JonatanMP/Jonatan_Matos_Electiva_2025_C2/Garabato I investigacion/garabato.jpg

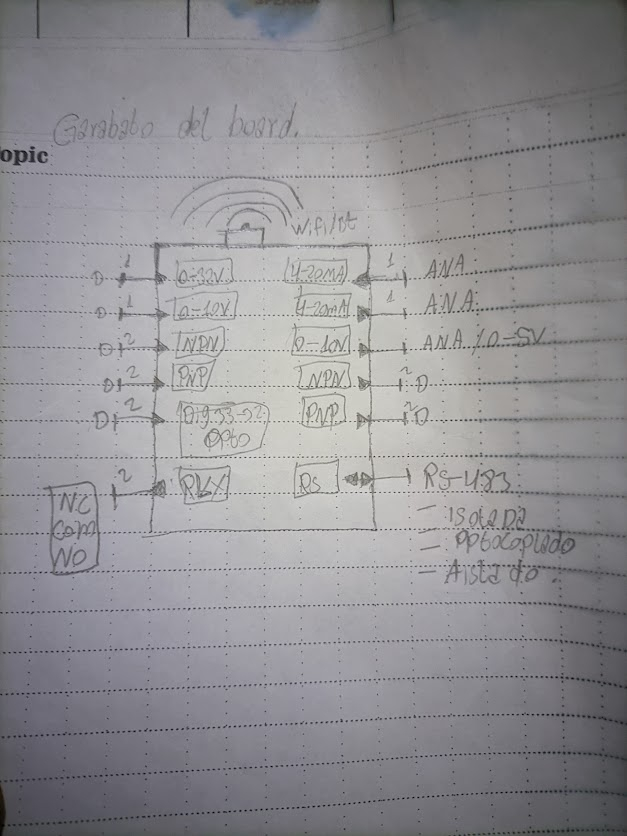
Garabato I investigacion/garabato.jpg
