JonatanMP/Jonatan_Matos_Electiva_2025_C2/README.md

# Jonatan_Matos_Electiva_2025_C2
HOLA PCB

_________________________________
