JonatanMP/Jonatan_Matos_Electiva_2025_C2/Garabato I investigacion/shematics guias/DIAGRAM.pdf

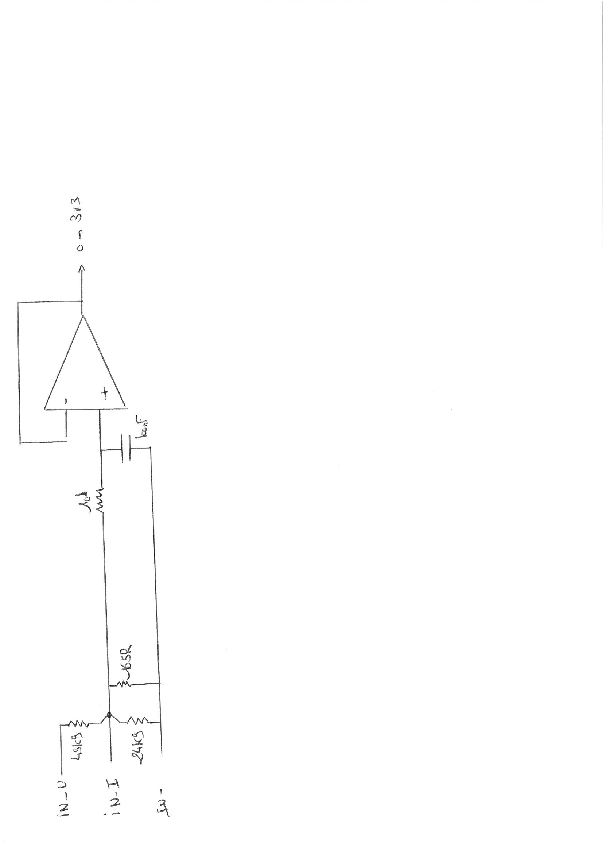
[picture p3: page 1]
