JonatanMP/Jonatan_Matos_Electiva_2025_C2/Garabato I investigacion/shematics guias/8877.Schematic_4_20mA_0_10V.png-1230x0.png

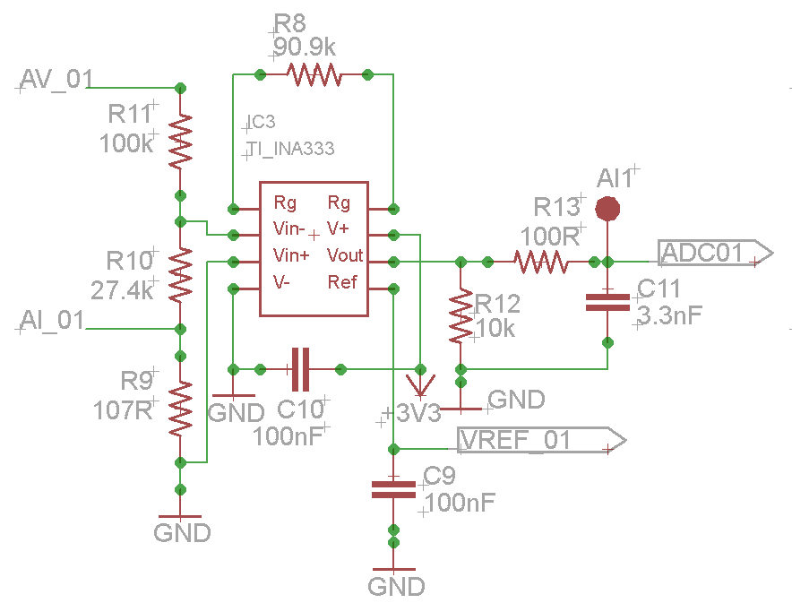
Garabato I investigacion/shematics guias/8877.Schematic_4_20mA_0_10V.png-1230x0.png
