JonatanMP/Jonatan_Matos_Electiva_2025_C2/Garabato I investigacion/shematics guias/Altium.PNG

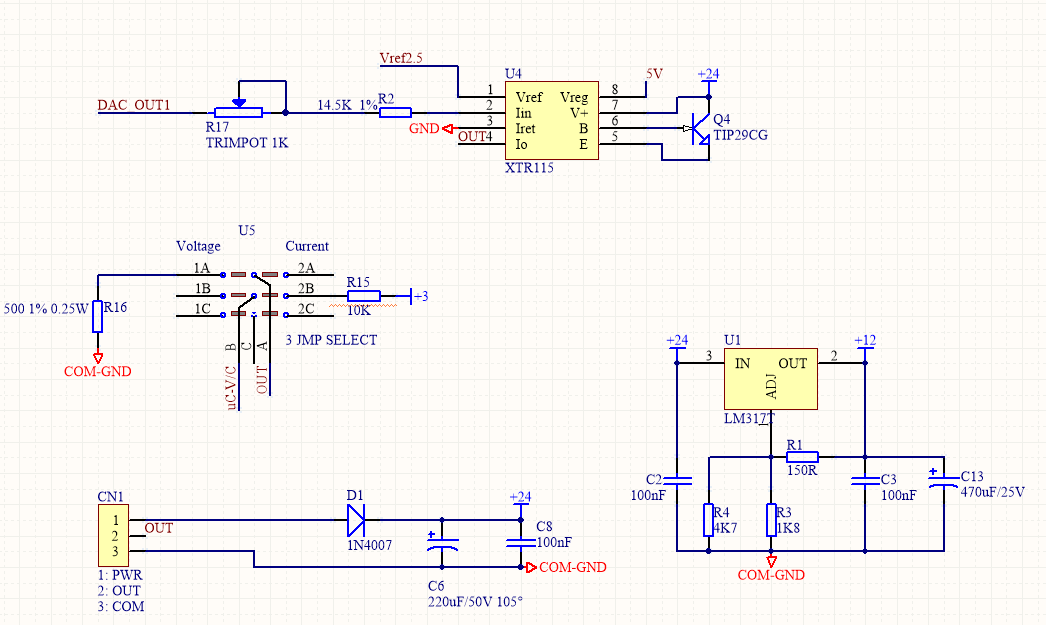
Garabato I investigacion/shematics guias/Altium.PNG
