JonatanMP/Jonatan_Matos_Electiva_2025_C2/Garabato I investigacion/shematics guias/Current_Limit_Fig37.JPG-1230x0.jpg

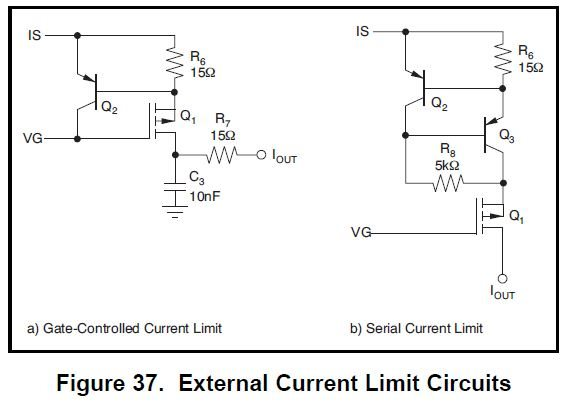
Garabato I investigacion/shematics guias/Current_Limit_Fig37.JPG-1230x0.jpg
