JonatanMP/Jonatan_Matos_Electiva_2025_C2/Garabato I investigacion/shematics guias/NPN I PNP.png

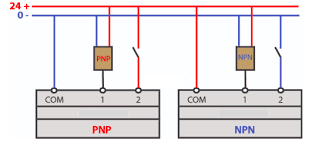
Garabato I investigacion/shematics guias/NPN I PNP.png
