JonatanMP/Jonatan_Matos_Electiva_2025_C2/CAD/3D/FreeCad/Case PLC.FCStd

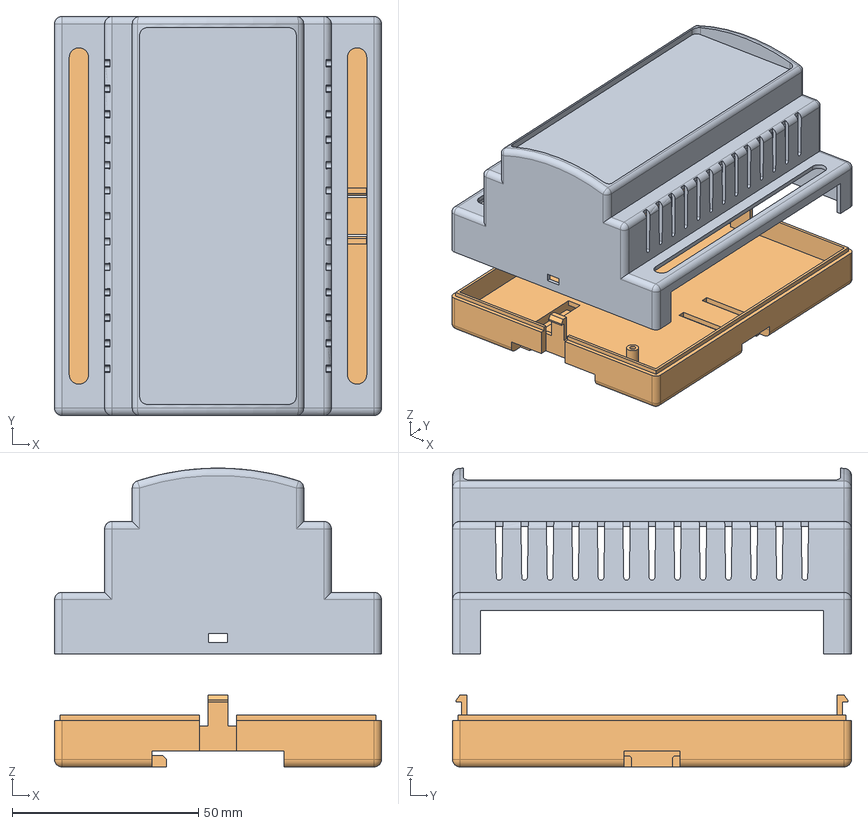
[picture p9: CAD file, 2025-06-11]
CAD/3D/FreeCad/Case PLC.FCStd
87.7 x 107.0 x 80.1 mm
Case
Base
