JonatanMP/Jonatan_Matos_Electiva_2025_C2/CAD/2D/FreeCad/TOP_VIEW_Base.dxf

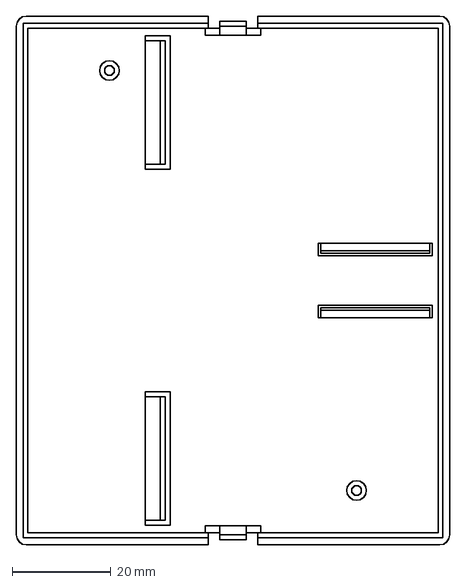
[picture p10: CAD file, 2025-06-11]
CAD/2D/FreeCad/TOP_VIEW_Base.dxf
87.7 x 107.0 mm
