JonatanMP/Jonatan_Matos_Electiva_2025_C2/NIVARA_PCB/NIVARA/NIVARA.kicad_pcb

## KiCad design NIVARA_PCB/NIVARA/NIVARA.kicad_pcb (2025-08-22)

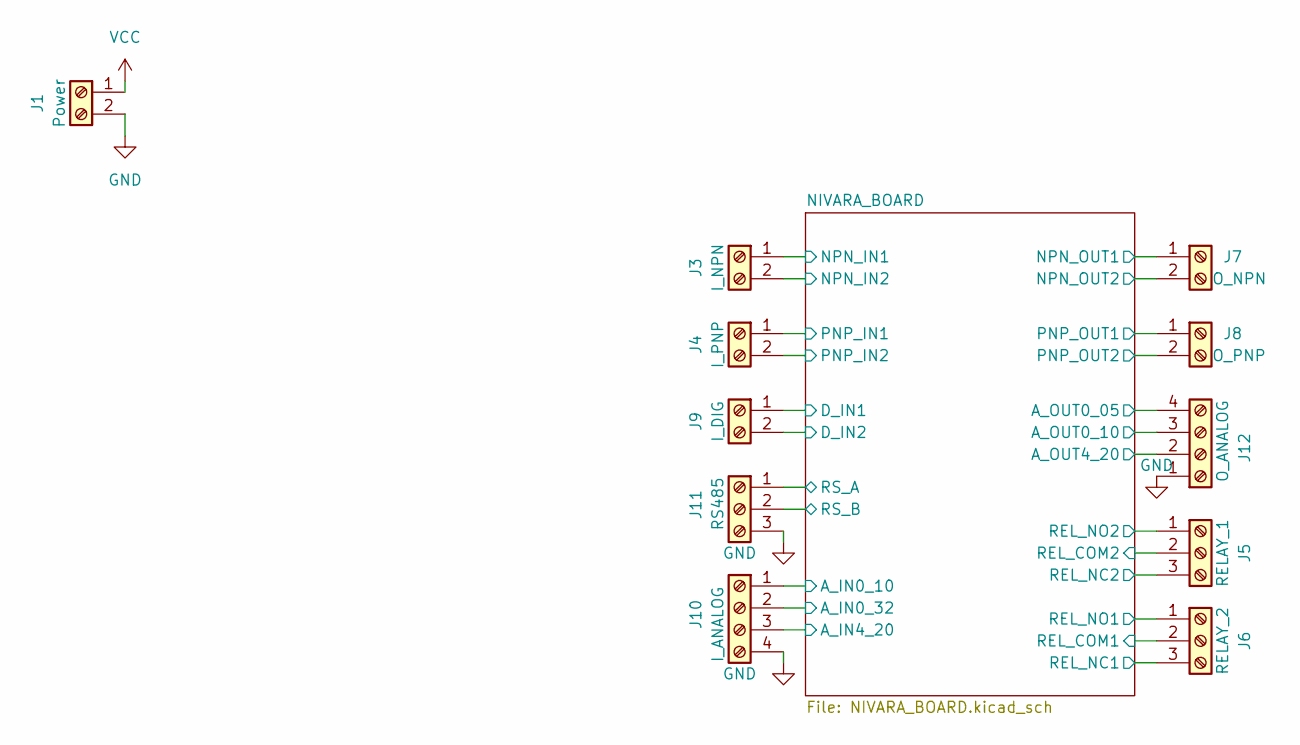
[picture p11: schematic NIVARA.kicad_sch]

Parts:
J1: Power; TerminalBlock_bornier-2_P5.08mm; PART NUMBERT DB128L-5.08-2P-OG-S
J3: I_NPN; TerminalBlock_bornier-2_P5.08mm; PART NUMBERT WJ500V-5.08-2P
J4: I_PNP; TerminalBlock_bornier-2_P5.08mm; PART NUMBERT WJ500V-5.08-2P
J5: RELAY_1; TerminalBlock_bornier-3_P5.08mm; PART NUMBERT WJ500V-5.08-3P
J6: RELAY_2; TerminalBlock_bornier-3_P5.08mm; PART NUMBERT WJ500V-5.08-3P
J7: O_NPN; TerminalBlock_bornier-2_P5.08mm; PART NUMBERT WJ500V-5.08-2P
J8: O_PNP; TerminalBlock_bornier-2_P5.08mm; PART NUMBERT WJ500V-5.08-2P
J9: I_DIG; TerminalBlock_bornier-2_P5.08mm; PART NUMBERT WJ500V-5.08-2P
J10: I_ANALOG; TerminalBlock_bornier-4_P5.08mm; PART NUMBERT WJ500V-5.08-4P
J11: RS485; TerminalBlock_bornier-3_P5.08mm; PART NUMBERT WJ500V-5.08-3P
J12: O_ANALOG; TerminalBlock_bornier-4_P5.08mm; PART NUMBERT WJ500V-5.08-4P

Connections:
/NIVARA_BOARD/A_IN0_10: J10.1; also elsewhere on the board
/NIVARA_BOARD/A_IN0_32: J10.2; also elsewhere on the board
/NIVARA_BOARD/A_IN4_20: J10.3; also elsewhere on the board
/NIVARA_BOARD/A_OUT0_05: J12.4; also elsewhere on the board
/NIVARA_BOARD/A_OUT0_10: J12.3; also elsewhere on the board
/NIVARA_BOARD/A_OUT4_20: J12.2; also elsewhere on the board
/NIVARA_BOARD/D_IN1: J9.1; also elsewhere on the board
/NIVARA_BOARD/D_IN2: J9.2; also elsewhere on the board
/NIVARA_BOARD/NPN_IN1: J3.1; also elsewhere on the board
/NIVARA_BOARD/NPN_IN2: J3.2; also elsewhere on the board
/NIVARA_BOARD/NPN_OUT1: J7.1; also elsewhere on the board
/NIVARA_BOARD/NPN_OUT2: J7.2; also elsewhere on the board
/NIVARA_BOARD/PNP_IN1: J4.1; also elsewhere on the board
/NIVARA_BOARD/PNP_IN2: J4.2; also elsewhere on the board
/NIVARA_BOARD/PNP_OUT1: J8.1; also elsewhere on the board
/NIVARA_BOARD/PNP_OUT2: J8.2; also elsewhere on the board
/NIVARA_BOARD/REL_COM1: J6.2; also elsewhere on the board
/NIVARA_BOARD/REL_COM2: J5.2; also elsewhere on the board
/NIVARA_BOARD/REL_NC1: J6.3; also elsewhere on the board
/NIVARA_BOARD/REL_NC2: J5.3; also elsewhere on the board
/NIVARA_BOARD/REL_NO1: J6.1; also elsewhere on the board
/NIVARA_BOARD/REL_NO2: J5.1; also elsewhere on the board
/NIVARA_BOARD/RS_A: J11.1; also elsewhere on the board
/NIVARA_BOARD/RS_B: J11.2; also elsewhere on the board
GND: J1.2, J10.4, J11.3, J12.1; also elsewhere on the board
VCC: J1.1; also elsewhere on the board

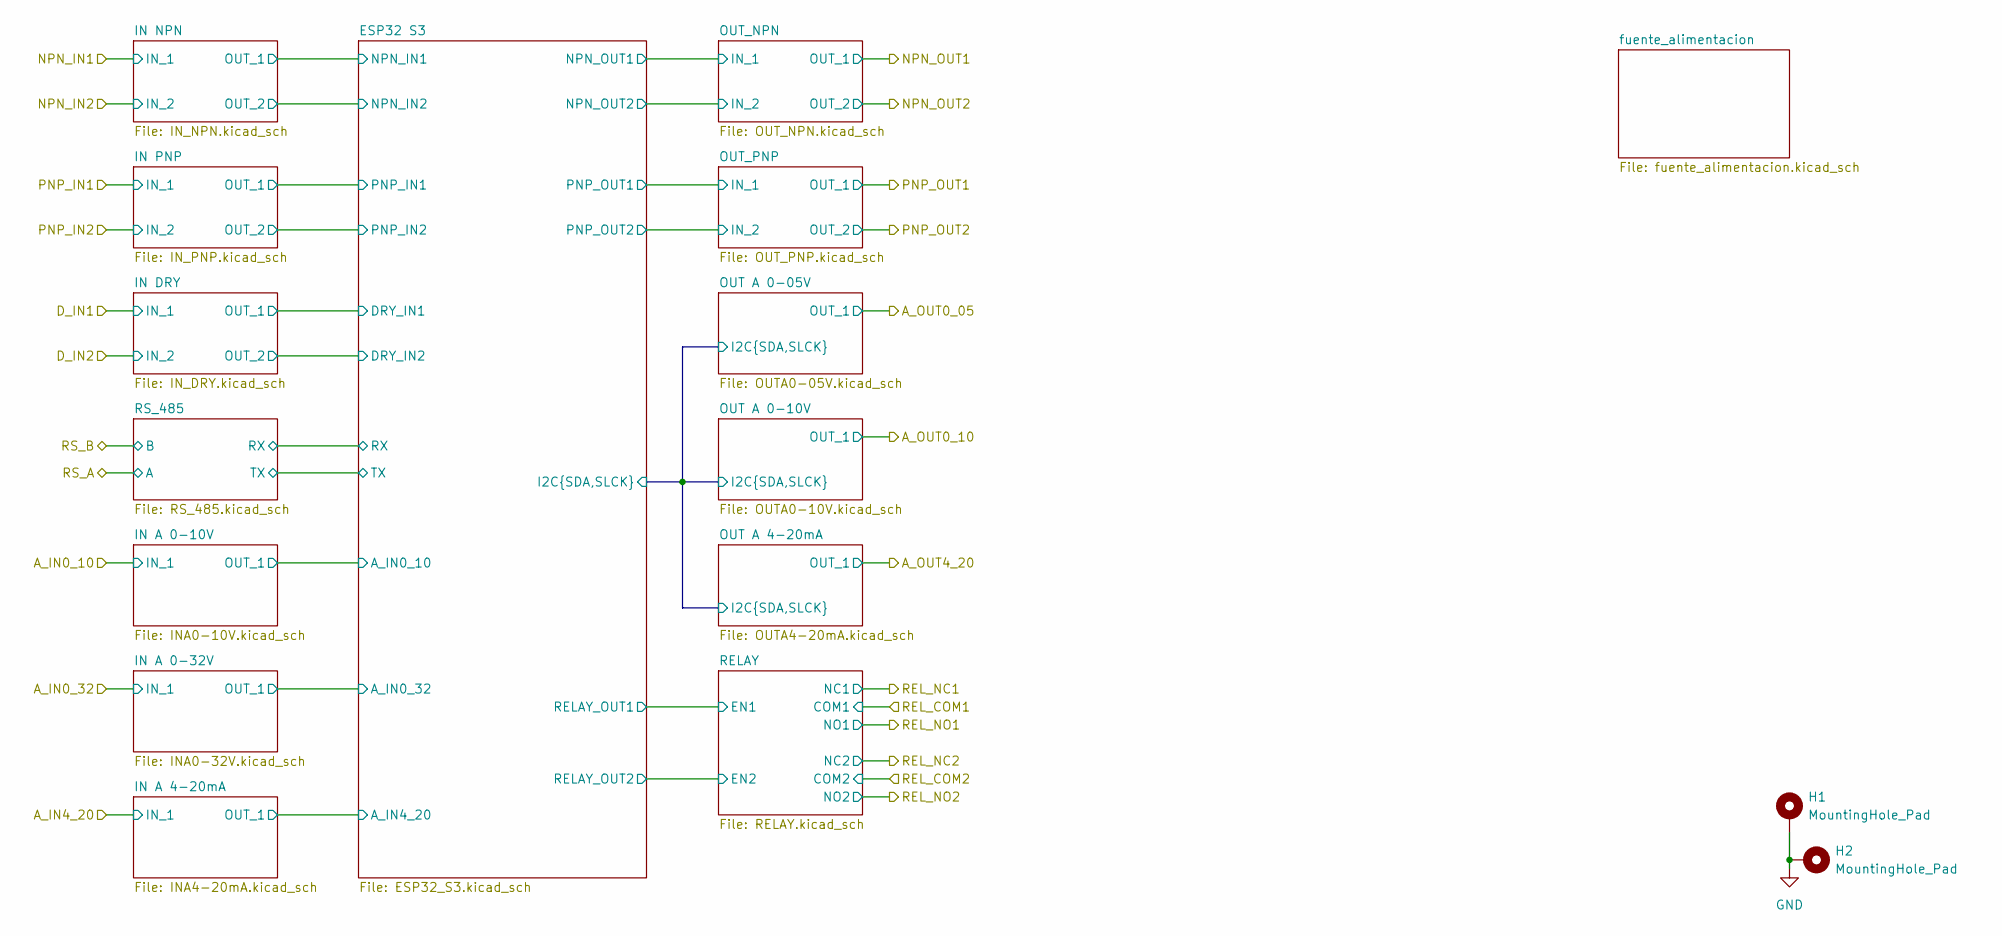
[picture p12: schematic NIVARA_BOARD.kicad_sch]

Parts:
H1, H2: MountingHole_Pad; MountingHole_2.2mm_M2_Pad_Via

Connections:
GND: H1.1, H2.1; also elsewhere on the board

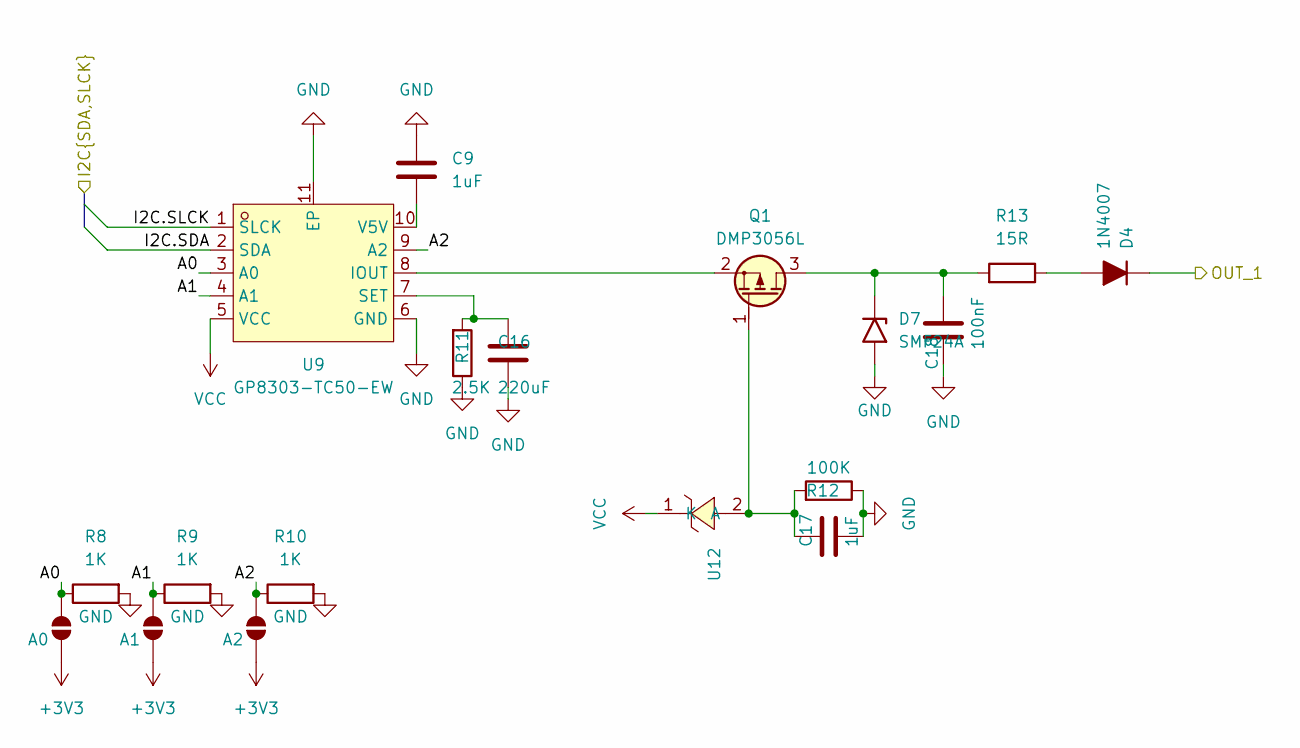
[picture p13: schematic OUTA4-20mA.kicad_sch]

Parts:
C9, C17: 1uF; C_0603_1608Metric; PART NUMBERT CL10A105KB8NNNC
C16: 220uF; C_0603_1608Metric; PART NUMBERT CC0603KRX7R9BB221
C18: 100nF; C_0603_1608Metric; PART NUMBERT CC0603KRX7R9BB104
D4: 1N4007; D_SOD-123F; PART NUMBERT 1N4007W 46MIL
D7: SMF24A; D_SMF
JP2: A0; SolderJumper-2_P1.3mm_Open_RoundedPad1.0x1.5mm
JP3: A1; SolderJumper-2_P1.3mm_Open_RoundedPad1.0x1.5mm
JP4: A2; SolderJumper-2_P1.3mm_Open_RoundedPad1.0x1.5mm
Q1: DMP3056L; SOT-23
R8, R9, R10: 1K; R_0603_1608Metric; PART NUMBERT RC0603FR-071KL
R11: 2.5K; R_0603_1608Metric; PART NUMBERT FRQ0805F2501TS
R12: 100K; R_0603_1608Metric; PART NUMBERT RC0603FR-07100KL
R13: 15R; R_1206_3216Metric; PART NUMBERT RC1206FR-0715RL
U9: GP8303-TC50-EW; ESOP-10_L4.9-W3.9-P1.00-LS6.1-BL-EP; LCSC Part C3445809
U12: ZMM12V_C5345999; LL-34_L3.5-W1.5-RD-2; LCSC Part C5345999

Connections:
+3V3: JP2.1 (A), JP3.1 (A), JP4.1 (A); also elsewhere on the board
/NIVARA_BOARD/A_OUT4_20: D4.1 (K); also elsewhere on the board
/NIVARA_BOARD/ESP32 S3/I2C.SDA: U9.2 (SDA); also elsewhere on the board
/NIVARA_BOARD/ESP32 S3/I2C.SLCK: U9.1 (SLCK); also elsewhere on the board
/NIVARA_BOARD/OUT A 4-20mA/A0: JP2.2 (B), R8.2, U9.3 (A0)
/NIVARA_BOARD/OUT A 4-20mA/A1: JP3.2 (B), R9.2, U9.4 (A1)
/NIVARA_BOARD/OUT A 4-20mA/A2: JP4.2 (B), R10.2, U9.9 (A2)
GND: C9.1, C16.2, C17.2, C18.1, D7.2 (A2), R8.1, R9.1, R10.1, R11.2, R12.2, U9.6 (GND), U9.11 (EP); also elsewhere on the board
unnamed: D4.2 (A), R13.2
unnamed: C18.2, D7.1 (A1), Q1.3 (D), R13.1
unnamed: C17.1, Q1.1 (G), R12.1, U12.2 (A)
unnamed: Q1.2 (S), U9.8 (IOUT)
unnamed: C16.1, R11.1, U9.7 (SET)
unnamed: C9.2, U9.10 (V5V)
VCC: U9.5 (VCC), U12.1 (K); also elsewhere on the board

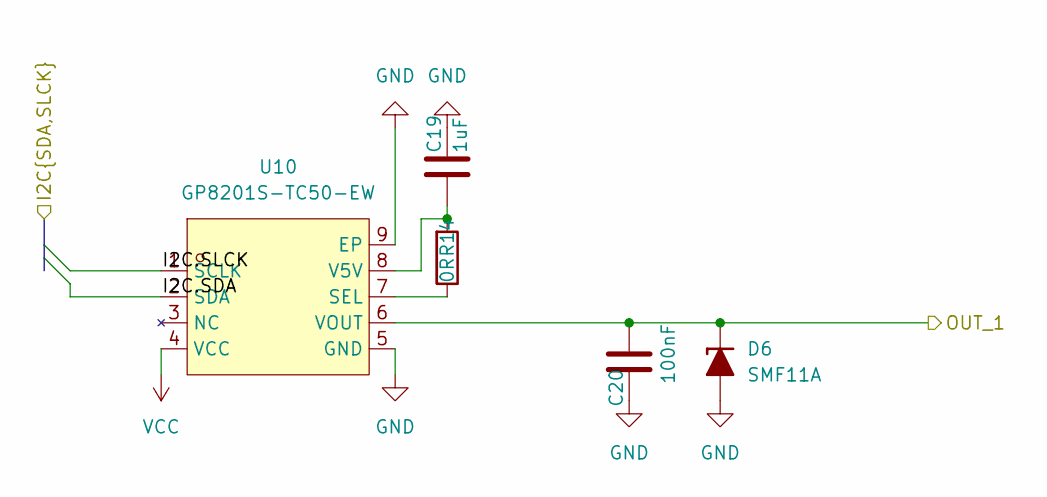
[picture p14: schematic OUTA0-10V.kicad_sch]

Parts:
C19: 1uF; C_0603_1608Metric; PART NUMBERT CL10A105KB8NNNC
C20: 100nF; C_0603_1608Metric; PART NUMBERT CC0603KRX7R9BB104
D6: SMF11A; D_SOD-123F
R14: 0R; R_0603_1608Metric; PART NUMBERT RC0603FR-070RL
U10: GP8201S-TC50-EW; ESOP-8_L4.9-W3.9-P1.27-LS6.0-BL-EP; LCSC Part C5240058

Connections:
/NIVARA_BOARD/A_OUT0_10: C20.2, D6.1 (K), U10.6 (VOUT); also elsewhere on the board
/NIVARA_BOARD/ESP32 S3/I2C.SDA: U10.2 (SDA); also elsewhere on the board
/NIVARA_BOARD/ESP32 S3/I2C.SLCK: U10.1 (SCLK); also elsewhere on the board
GND: C19.1, C20.1, D6.2 (A), U10.5 (GND), U10.9 (EP); also elsewhere on the board
unnamed: R14.2, U10.7 (SEL)
unnamed: C19.2, R14.1, U10.8 (V5V)
VCC: U10.4 (VCC); also elsewhere on the board

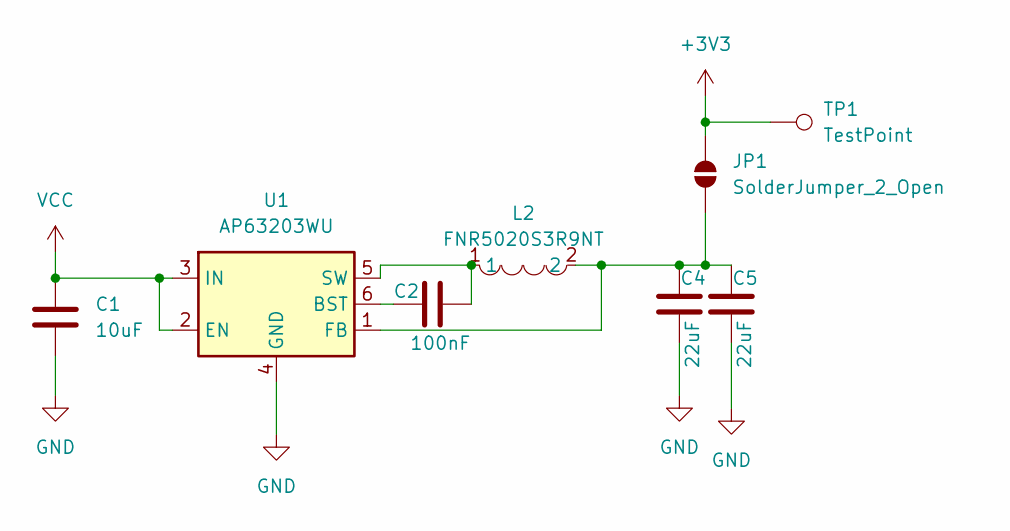
[picture p15: schematic fuente_alimentacion.kicad_sch]

Parts:
C1: 10uF; C_1206_3216Metric; PART NUMBERT CL31A106KBHNNNE
C2: 100nF; C_0603_1608Metric; PART NUMBERT CC0603KRX7R9BB104
C4, C5: 22uF; C_0603_1608Metric; PART NUMBERT CL10A226MP8NUNE
JP1: SolderJumper_2_Open; SolderJumper-2_P1.3mm_Open_RoundedPad1.0x1.5mm
L2: FNR5020S3R9NT; IND-SMD_L5.0-W5.0_FNR50XXS; LCSC Part C167928
TP1: TestPoint; TestPoint_THTPad_D1.0mm_Drill0.5mm
U1: AP63203WU; TSOT-23-6; PART NUMBERT AP63203WU-7

Connections:
+3V3: JP1.2 (B), TP1.1; also elsewhere on the board
GND: C1.2, C4.2, C5.2, U1.4 (GND); also elsewhere on the board
unnamed: C4.1, C5.1, JP1.1 (A), L2.2, U1.1 (FB)
unnamed: C2.1, U1.6 (BST)
unnamed: C2.2, L2.1, U1.5 (SW)
VCC: C1.1, U1.2 (EN), U1.3 (IN); also elsewhere on the board

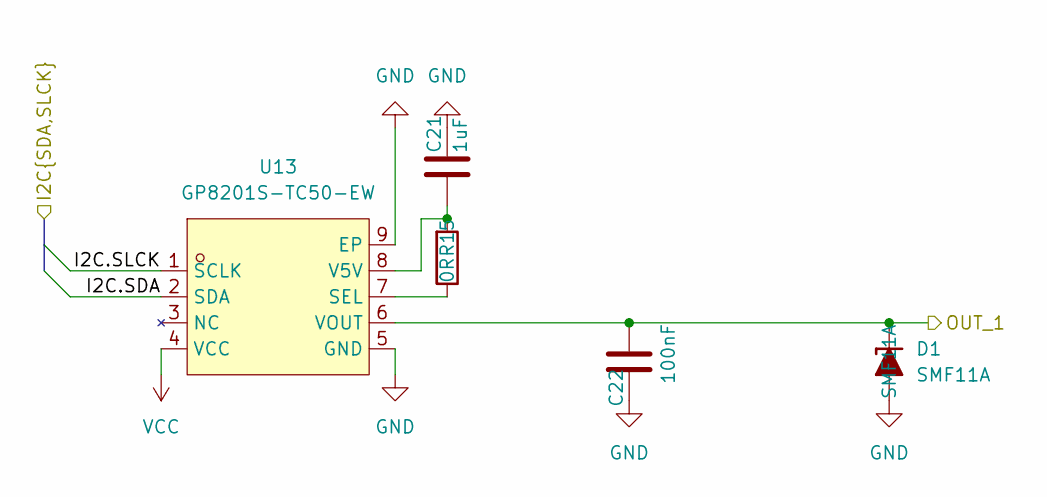
[picture p16: schematic OUTA0-05V.kicad_sch]

Parts:
C21: 1uF; C_0603_1608Metric; PART NUMBERT CL10A105KB8NNNC
C22: 100nF; C_0603_1608Metric; PART NUMBERT CC0603KRX7R9BB104
D1: SMF11A; D_SOD-123F; PART NUMBERT SMF11A
R15: 0R; R_0603_1608Metric; PART NUMBERT RC0603FR-070RL
U13: GP8201S-TC50-EW; ESOP-8_L4.9-W3.9-P1.27-LS6.0-BL-EP; LCSC Part C5240058

Connections:
/NIVARA_BOARD/A_OUT0_05: C22.2, D1.1 (K), U13.6 (VOUT); also elsewhere on the board
/NIVARA_BOARD/ESP32 S3/I2C.SDA: U13.2 (SDA); also elsewhere on the board
/NIVARA_BOARD/ESP32 S3/I2C.SLCK: U13.1 (SCLK); also elsewhere on the board
GND: C21.1, C22.1, D1.2 (A), U13.5 (GND), U13.9 (EP); also elsewhere on the board
unnamed: R15.2, U13.7 (SEL)
unnamed: C21.2, R15.1, U13.8 (V5V)
VCC: U13.4 (VCC); also elsewhere on the board

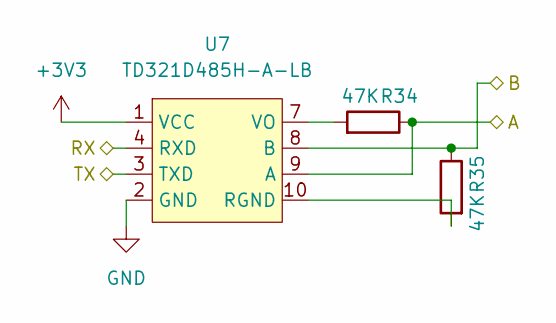
[picture p17: schematic RS_485.kicad_sch]

Parts:
R34, R35: 47K; R_0603_1608Metric
U7: TD321D485H-A-LB

Connections:
+3V3: U7.1 (VCC); also elsewhere on the board
/NIVARA_BOARD/ESP32 S3/RX: U7.4 (RXD); also elsewhere on the board
/NIVARA_BOARD/ESP32 S3/TX: U7.3 (TXD); also elsewhere on the board
/NIVARA_BOARD/RS_A: R34.2, U7.9 (A); also elsewhere on the board
/NIVARA_BOARD/RS_B: R35.2, U7.8 (B); also elsewhere on the board
GND: U7.2 (GND); also elsewhere on the board
unnamed: R35.1, U7.10 (RGND)
unnamed: R34.1, U7.7 (VO)

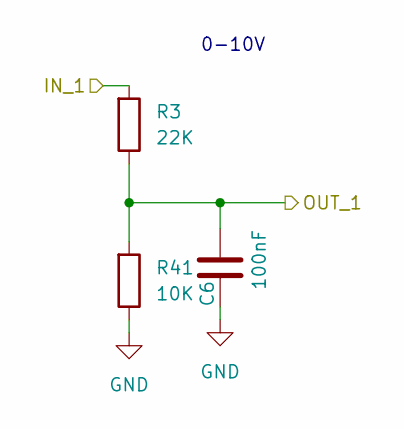
[picture p18: schematic INA0-10V.kicad_sch]

Parts:
C6: 100nF; C_0603_1608Metric; PART NUMBERT CC0603KRX7R9BB104
R3: 22K; R_0603_1608Metric; PART NUMBERT RC0603FR-0722KL
R41: 10K; R_0603_1608Metric

Connections:
/NIVARA_BOARD/A_IN0_10: R3.1; also elsewhere on the board
/NIVARA_BOARD/ESP32 S3/A_IN0_10: C6.2, R3.2, R41.1; also elsewhere on the board
GND: C6.1, R41.2; also elsewhere on the board

Notes on the sheet:
0-10V

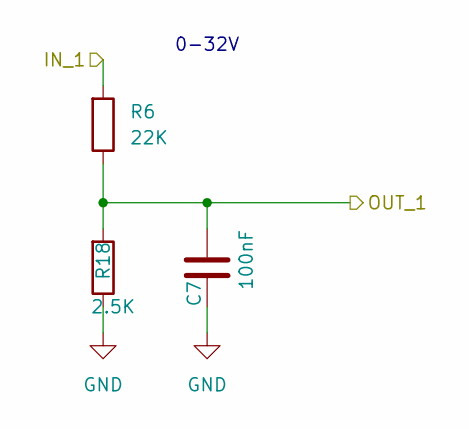
[picture p19: schematic INA0-32V.kicad_sch]

Parts:
C7: 100nF; C_0603_1608Metric; PART NUMBERT CC0603KRX7R9BB104
R6: 22K; R_0603_1608Metric; PART NUMBERT RC0603FR-0722KL
R18: 2.5K; R_0603_1608Metric; PART NUMBERT FRQ0805F2501TS

Connections:
/NIVARA_BOARD/A_IN0_32: R6.1; also elsewhere on the board
/NIVARA_BOARD/ESP32 S3/A_IN0_32: C7.2, R6.2, R18.1; also elsewhere on the board
GND: C7.1, R18.2; also elsewhere on the board

Notes on the sheet:
0-32V

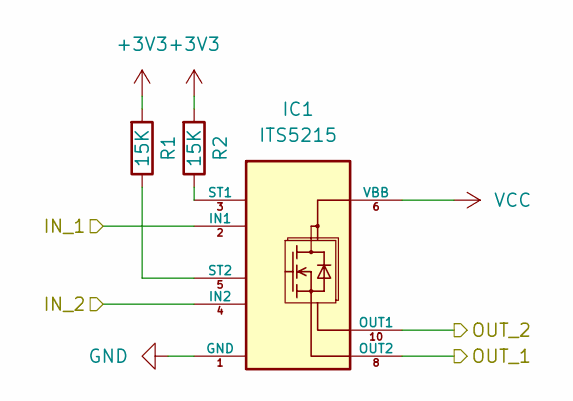
[picture p20: schematic OUT_PNP.kicad_sch]

Parts:
IC1: ITS5215; Infineon_PG-DSO-12-9_ThermalVias
R1, R2: 15K; R_0603_1608Metric; PART NUMBERT RC0603FR-0715KL

Connections:
+3V3: R1.1, R2.1; also elsewhere on the board
/NIVARA_BOARD/ESP32 S3/PNP_OUT1: IC1.2 (IN1); also elsewhere on the board
/NIVARA_BOARD/ESP32 S3/PNP_OUT2: IC1.4 (IN2); also elsewhere on the board
/NIVARA_BOARD/PNP_OUT1: IC1.8 (OUT2); also elsewhere on the board
/NIVARA_BOARD/PNP_OUT2: IC1.10 (OUT1); also elsewhere on the board
GND: IC1.1 (GND); also elsewhere on the board
unnamed: IC1.3 (ST1), R2.2
unnamed: IC1.5 (ST2), R1.2
VCC: IC1.6 (VBB), IC1.12 (VBB), IC1.13 (VBB); also elsewhere on the board

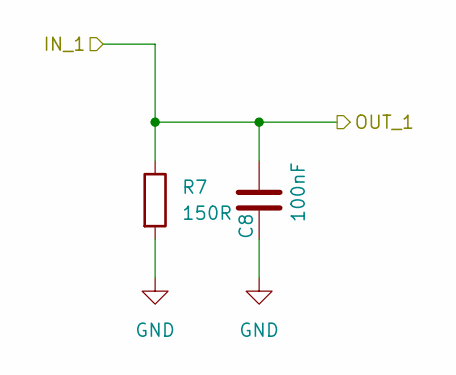
[picture p21: schematic INA4-20mA.kicad_sch]

Parts:
C8: 100nF; C_0603_1608Metric; PART NUMBERT CC0603KRX7R9BB104
R7: 150R; R_0603_1608Metric; PART NUMBERT RC0603FR-07150RL

Connections:
/NIVARA_BOARD/A_IN4_20: C8.2, R7.1; also elsewhere on the board
GND: C8.1, R7.2; also elsewhere on the board

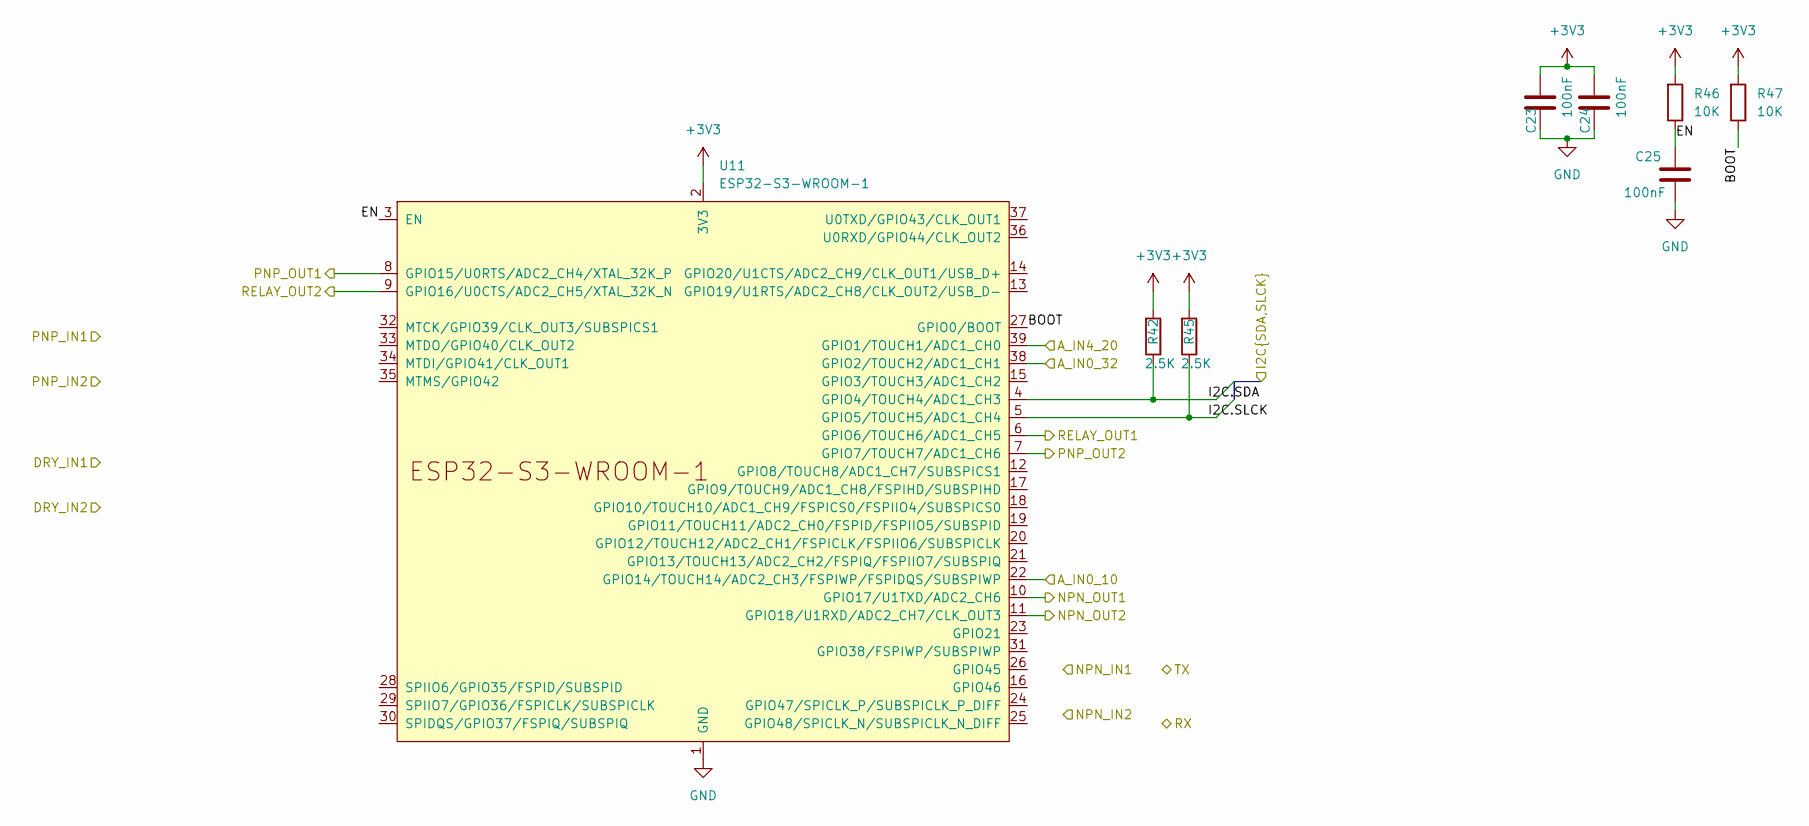
[picture p22: schematic ESP32_S3.kicad_sch]

Parts:
C23, C24, C25: 100nF; C_0603_1608Metric; PART NUMBERT CC0603KRX7R9BB104
R42, R45: 2.5K; R_0603_1608Metric; PART NUMBERT FRQ0805F2501TS
R46, R47: 10K; R_0603_1608Metric
U11: ESP32-S3-WROOM-1

Connections:
+3V3: C23.2, C24.2, R42.1, R45.1, R46.1, R47.1, U11.2 (3V3); also elsewhere on the board
/NIVARA_BOARD/A_IN4_20: U11.39 (GPIO1/TOUCH1/ADC1_CH0); also elsewhere on the board
/NIVARA_BOARD/ESP32 S3/A_IN0_10: U11.22 (GPIO14/TOUCH14/ADC2_CH3/FSPIWP/FSPIDQS/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); also elsewhere on the board
/NIVARA_BOARD/ESP32 S3/A_IN0_32: U11.38 (GPIO2/TOUCH2/ADC1_CH1); also elsewhere on the board
/NIVARA_BOARD/ESP32 S3/BOOT: R47.2, U11.27 (GPIO0/BOOT)
/NIVARA_BOARD/ESP32 S3/DRY_IN1: U11.21 (GPIO13/TOUCH13/ADC2_CH2/FSPIQ/FSPIIO7/S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); also elsewhere on the board
/NIVARA_BOARD/ESP32 S3/DRY_IN2: U11.20 (GPIO12/TOUCH12/ADC2_CH1/FSPICLK/FSPIIO6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); also elsewhere on the board
/NIVARA_BOARD/ESP32 S3/EN: C25.2, R46.2, U11.3 (EN)
/NIVARA_BOARD/ESP32 S3/I2C.SDA: R42.2, U11.4 (GPIO4/TOUCH4/ADC1_CH3); also elsewhere on the board
/NIVARA_BOARD/ESP32 S3/I2C.SLCK: R45.2, U11.5 (GPIO5/TOUCH5/ADC1_CH4); also elsewhere on the board
/NIVARA_BOARD/ESP32 S3/NPN_IN1: U11.26 (GPIO45); also elsewhere on the board
/NIVARA_BOARD/ESP32 S3/NPN_IN2: U11.25 (GPIO48/SPICLK_N/SUBSPICLK_N_DIFF); also elsewhere on the board
/NIVARA_BOARD/ESP32 S3/NPN_OUT1: U11.10 (GPIO17/U1TXD/ADC2_CH6); also elsewhere on the board
/NIVARA_BOARD/ESP32 S3/NPN_OUT2: U11.11 (GPIO18/U1RXD/ADC2_CH7/CLK_OUT3); also elsewhere on the board
/NIVARA_BOARD/ESP32 S3/PNP_IN1: U11.24 (GPIO47/SPICLK_P/SUBSPICLK_P_DIFF); also elsewhere on the board
/NIVARA_BOARD/ESP32 S3/PNP_IN2: U11.23 (GPIO21); also elsewhere on the board
/NIVARA_BOARD/ESP32 S3/PNP_OUT1: U11.8 (GPIO15/U0RTS/ADC2_CH4/XTAL_32K_P); also elsewhere on the board
/NIVARA_BOARD/ESP32 S3/PNP_OUT2: U11.7 (GPIO7/TOUCH7/ADC1_CH6); also elsewhere on the board
/NIVARA_BOARD/ESP32 S3/RELAY_OUT1: U11.6 (GPIO6/TOUCH6/ADC1_CH5); also elsewhere on the board
/NIVARA_BOARD/ESP32 S3/RELAY_OUT2: U11.9 (GPIO16/U0CTS/ADC2_CH5/XTAL_32K_N); also elsewhere on the board
/NIVARA_BOARD/ESP32 S3/RX: U11.18 (GPIO10/TOUCH10/ADC1_CH9/FSPICS0/FSPIIO4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); also elsewhere on the board
/NIVARA_BOARD/ESP32 S3/TX: U11.19 (GPIO11/TOUCH11/ADC2_CH0/FSPID/FSPIIO5/S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); also elsewhere on the board
GND: C23.1, C24.1, C25.1, U11.1 (GND), U11.40 (GND), U11.41 (GND); also elsewhere on the board

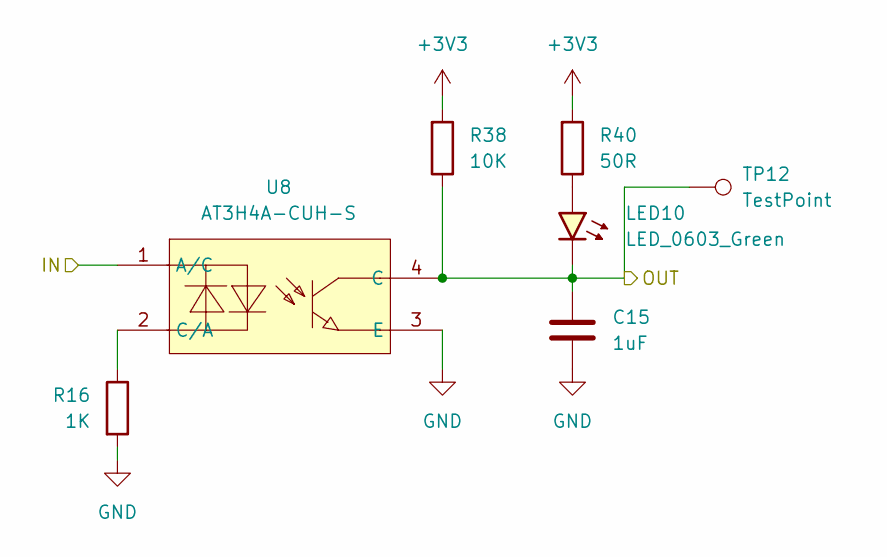
[picture p23: schematic IN_DRY_Opto.kicad_sch]

Parts:
C15: 1uF; C_0603_1608Metric; PART NUMBERT CL10A105KB8NNNC
LED10: LED_0603_Green; LED_0603_1608Metric; PART NUMBERT XL-1608UOC-06
R16: 1K; R_0603_1608Metric; PART NUMBERT RC0603FR-071KL
R38: 10K; R_0603_1608Metric
R40: 50R; R_0603_1608Metric; PART NUMBERT RT0603BRE0750RL
TP12: TestPoint; TestPoint_THTPad_D1.0mm_Drill0.5mm
U8: AT3H4A-CUH-S; SSOP-4_L2.7-W4.6-P1.27-LS7.0-TL; PART NUMBERT AT3H4A-CUH-S; LCSC Part C20612634

Connections:
+3V3: R38.1, R40.1; also elsewhere on the board
/NIVARA_BOARD/D_IN1: U8.1 (A/C); also elsewhere on the board
/NIVARA_BOARD/ESP32 S3/DRY_IN1: C15.1, LED10.1 (K), R38.2, TP12.1, U8.4 (C); also elsewhere on the board
GND: C15.2, R16.1, U8.3 (E); also elsewhere on the board
unnamed: LED10.2 (A), R40.2
unnamed: R16.2, U8.2 (C/A)

Parts of its further copies:
C14: 1uF; C_0603_1608Metric; PART NUMBERT CL10A105KB8NNNC
LED9: LED_0603_Green; LED_0603_1608Metric; PART NUMBERT XL-1608UOC-06
R17: 1K; R_0603_1608Metric; PART NUMBERT RC0603FR-071KL
R37: 10K; R_0603_1608Metric
R39: 50R; R_0603_1608Metric; PART NUMBERT RT0603BRE0750RL
TP11: TestPoint; TestPoint_THTPad_D1.0mm_Drill0.5mm
U3: AT3H4A-CUH-S; SSOP-4_L2.7-W4.6-P1.27-LS7.0-TL; PART NUMBERT AT3H4A-CUH-S; LCSC Part C20612634

Connections of its further copies:
+3V3: R37.1, R39.1; also elsewhere on the board
/NIVARA_BOARD/D_IN2: U3.1 (A/C); also elsewhere on the board
/NIVARA_BOARD/ESP32 S3/DRY_IN2: C14.1, LED9.1 (K), R37.2, TP11.1, U3.4 (C); also elsewhere on the board
GND: C14.2, R17.1, U3.3 (E); also elsewhere on the board
unnamed: LED9.2 (A), R39.2
unnamed: R17.2, U3.2 (C/A)

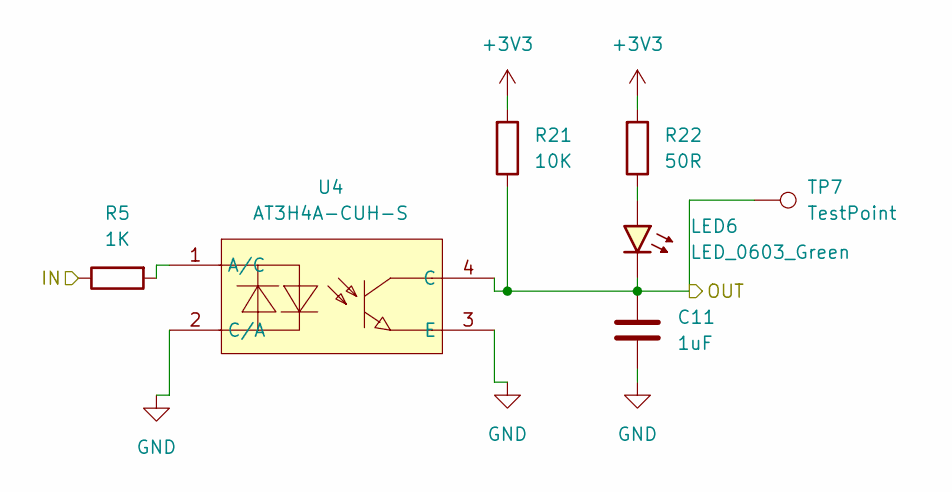
[picture p24: schematic IN_NPN_ISOLATE.kicad_sch]

Parts:
C11: 1uF; C_0603_1608Metric; PART NUMBERT CL10A105KB8NNNC
LED6: LED_0603_Green; LED_0603_1608Metric; PART NUMBERT XL-1608UOC-06
R5: 1K; R_0603_1608Metric; PART NUMBERT RC0603FR-071KL
R21: 10K; R_0603_1608Metric
R22: 50R; R_0603_1608Metric; PART NUMBERT RT0603BRE0750RL
TP7: TestPoint; TestPoint_THTPad_D1.0mm_Drill0.5mm
U4: AT3H4A-CUH-S; SSOP-4_L2.7-W4.6-P1.27-LS7.0-TL; PART NUMBERT AT3H4A-CUH-S; LCSC Part C20612634

Connections:
+3V3: R21.1, R22.1; also elsewhere on the board
/NIVARA_BOARD/ESP32 S3/NPN_IN2: C11.1, LED6.1 (K), R21.2, TP7.1, U4.4 (C); also elsewhere on the board
/NIVARA_BOARD/NPN_IN2: R5.2; also elsewhere on the board
GND: C11.2, U4.2 (C/A), U4.3 (E); also elsewhere on the board
unnamed: LED6.2 (A), R22.2
unnamed: R5.1, U4.1 (A/C)

Parts of its further copies:
C10: 1uF; C_0603_1608Metric; PART NUMBERT CL10A105KB8NNNC
LED5: LED_0603_Green; LED_0603_1608Metric; PART NUMBERT XL-1608UOC-06
R4: 1K; R_0603_1608Metric; PART NUMBERT RC0603FR-071KL
R19: 10K; R_0603_1608Metric
R20: 50R; R_0603_1608Metric; PART NUMBERT RT0603BRE0750RL
TP6: TestPoint; TestPoint_THTPad_D1.0mm_Drill0.5mm
U2: AT3H4A-CUH-S; SSOP-4_L2.7-W4.6-P1.27-LS7.0-TL; PART NUMBERT AT3H4A-CUH-S; LCSC Part C20612634

Connections of its further copies:
+3V3: R19.1, R20.1; also elsewhere on the board
/NIVARA_BOARD/ESP32 S3/NPN_IN1: C10.1, LED5.1 (K), R19.2, TP6.1, U2.4 (C); also elsewhere on the board
/NIVARA_BOARD/NPN_IN1: R4.2; also elsewhere on the board
GND: C10.2, U2.2 (C/A), U2.3 (E); also elsewhere on the board
unnamed: LED5.2 (A), R20.2
unnamed: R4.1, U2.1 (A/C)

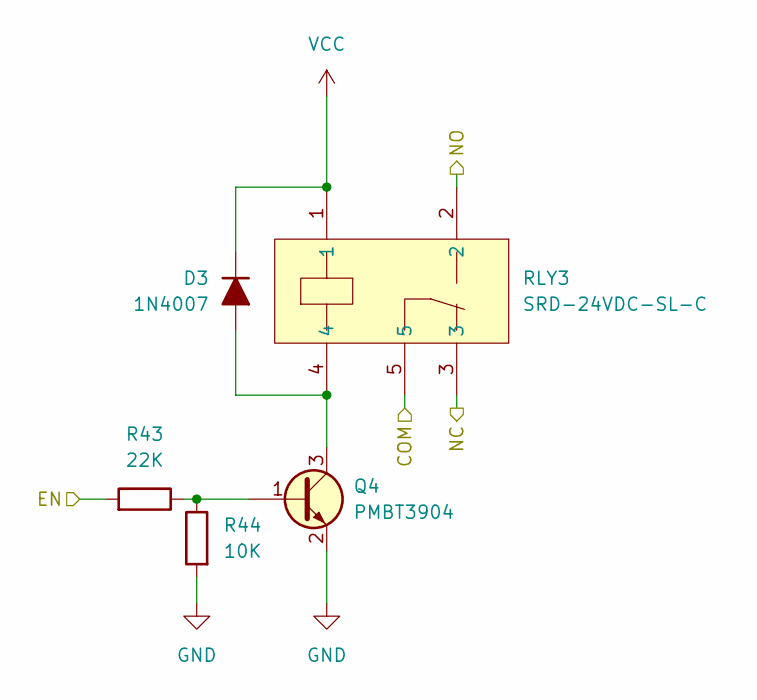
[picture p25: schematic relay_swichint.kicad_sch]

Parts:
D3: 1N4007; D_SOD-123F; PART NUMBERT 1N4007W 46MIL
Q4: PMBT3904; SOT-23; PART NUMBERT PMBT3904,215
R43: 22K; R_0603_1608Metric; PART NUMBERT RC0603FR-0722KL
R44: 10K; R_0603_1608Metric
RLY3: SRD-24VDC-SL-C; RELAY-TH_SRD-XXVDC-XL-C; PART NUMBERT SRD-24VDC-SL-C; LCSC Part C15840

Connections:
/NIVARA_BOARD/ESP32 S3/RELAY_OUT1: R43.1; also elsewhere on the board
/NIVARA_BOARD/REL_COM1: RLY3.5; also elsewhere on the board
/NIVARA_BOARD/REL_NC1: RLY3.3; also elsewhere on the board
/NIVARA_BOARD/REL_NO1: RLY3.2; also elsewhere on the board
GND: Q4.2 (E), R44.1; also elsewhere on the board
unnamed: D3.2 (A), Q4.3 (C), RLY3.4
unnamed: Q4.1 (B), R43.2, R44.2
VCC: D3.1 (K), RLY3.1; also elsewhere on the board

Parts of its further copies:
D2: 1N4007; D_SOD-123F; PART NUMBERT 1N4007W 46MIL
Q2: PMBT3904; SOT-23; PART NUMBERT PMBT3904,215
R32: 22K; R_0603_1608Metric; PART NUMBERT RC0603FR-0722KL
R33: 10K; R_0603_1608Metric
RLY2: SRD-24VDC-SL-C; RELAY-TH_SRD-XXVDC-XL-C; PART NUMBERT SRD-24VDC-SL-C; LCSC Part C15840

Connections of its further copies:
/NIVARA_BOARD/ESP32 S3/RELAY_OUT2: R32.1; also elsewhere on the board
/NIVARA_BOARD/REL_COM2: RLY2.5; also elsewhere on the board
/NIVARA_BOARD/REL_NC2: RLY2.3; also elsewhere on the board
/NIVARA_BOARD/REL_NO2: RLY2.2; also elsewhere on the board
GND: Q2.2 (E), R33.1; also elsewhere on the board
unnamed: D2.2 (A), Q2.3 (C), RLY2.4
unnamed: Q2.1 (B), R32.2, R33.2
VCC: D2.1 (K), RLY2.1; also elsewhere on the board

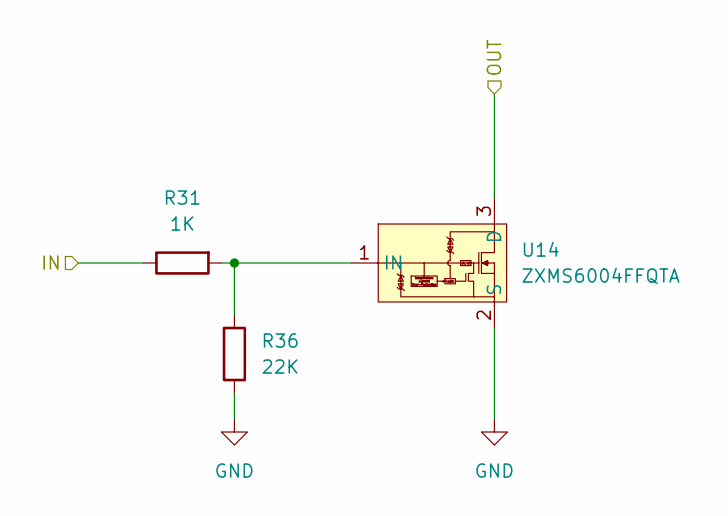
[picture p26: schematic O_NPN.kicad_sch]

Parts:
R31: 1K; R_0603_1608Metric; PART NUMBERT RC0603FR-071KL
R36: 22K; R_0603_1608Metric; PART NUMBERT RC0603FR-0722KL
U14: ZXMS6004FFQTA; SOT-23F_L2.9-W1.8-P0.95-LS2.4-BR

Connections:
/NIVARA_BOARD/ESP32 S3/NPN_OUT2: R31.2; also elsewhere on the board
/NIVARA_BOARD/NPN_OUT2: U14.3 (D); also elsewhere on the board
GND: R36.2, U14.2 (S); also elsewhere on the board
unnamed: R31.1, R36.1, U14.1 (IN)

Parts of its further copies:
R23: 1K; R_0603_1608Metric; PART NUMBERT RC0603FR-071KL
R30: 22K; R_0603_1608Metric; PART NUMBERT RC0603FR-0722KL
U15: ZXMS6004FFQTA; SOT-23F_L2.9-W1.8-P0.95-LS2.4-BR

Connections of its further copies:
/NIVARA_BOARD/ESP32 S3/NPN_OUT1: R23.2; also elsewhere on the board
/NIVARA_BOARD/NPN_OUT1: U15.3 (D); also elsewhere on the board
GND: R30.2, U15.2 (S); also elsewhere on the board
unnamed: R23.1, R30.1, U15.1 (IN)

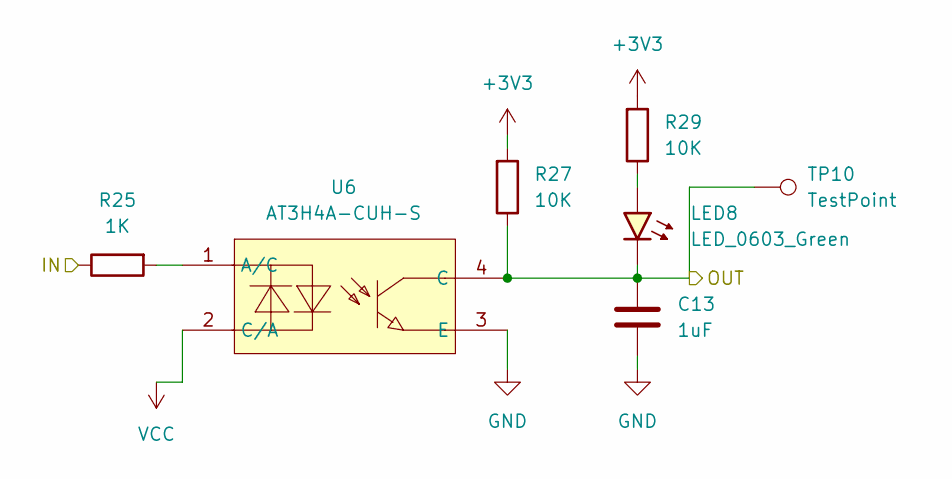
[picture p27: schematic IN_PNP_ISOLATE.kicad_sch]

Parts:
C13: 1uF; C_0603_1608Metric; PART NUMBERT CL10A105KB8NNNC
LED8: LED_0603_Green; LED_0603_1608Metric; PART NUMBERT XL-1608UOC-06
R25: 1K; R_0603_1608Metric; PART NUMBERT RC0603FR-071KL
R27, R29: 10K; R_0603_1608Metric
TP10: TestPoint; TestPoint_THTPad_D1.0mm_Drill0.5mm
U6: AT3H4A-CUH-S; SSOP-4_L2.7-W4.6-P1.27-LS7.0-TL; PART NUMBERT AT3H4A-CUH-S; LCSC Part C20612634

Connections:
+3V3: R27.1, R29.1; also elsewhere on the board
/NIVARA_BOARD/ESP32 S3/PNP_IN2: C13.1, LED8.1 (K), R27.2, TP10.1, U6.4 (C); also elsewhere on the board
/NIVARA_BOARD/PNP_IN2: R25.2; also elsewhere on the board
GND: C13.2, U6.3 (E); also elsewhere on the board
unnamed: LED8.2 (A), R29.2
unnamed: R25.1, U6.1 (A/C)
VCC: U6.2 (C/A); also elsewhere on the board

Parts of its further copies:
C12: 1uF; C_0603_1608Metric; PART NUMBERT CL10A105KB8NNNC
LED7: LED_0603_Green; LED_0603_1608Metric; PART NUMBERT XL-1608UOC-06
R24: 1K; R_0603_1608Metric; PART NUMBERT RC0603FR-071KL
R26, R28: 10K; R_0603_1608Metric
TP9: TestPoint; TestPoint_THTPad_D1.0mm_Drill0.5mm
U5: AT3H4A-CUH-S; SSOP-4_L2.7-W4.6-P1.27-LS7.0-TL; PART NUMBERT AT3H4A-CUH-S; LCSC Part C20612634

Connections of its further copies:
+3V3: R26.1, R28.1; also elsewhere on the board
/NIVARA_BOARD/ESP32 S3/PNP_IN1: C12.1, LED7.1 (K), R26.2, TP9.1, U5.4 (C); also elsewhere on the board
/NIVARA_BOARD/PNP_IN1: R24.2; also elsewhere on the board
GND: C12.2, U5.3 (E); also elsewhere on the board
unnamed: LED7.2 (A), R28.2
unnamed: R24.1, U5.1 (A/C)
VCC: U5.2 (C/A); also elsewhere on the board
