JonatanMP/Jonatan_Matos_Electiva_2025_C2/NIVARA_PCB/NIVARA/NIVARA.kicad_pcb

## KiCad design NIVARA_PCB/NIVARA/NIVARA.kicad_pcb (continued)

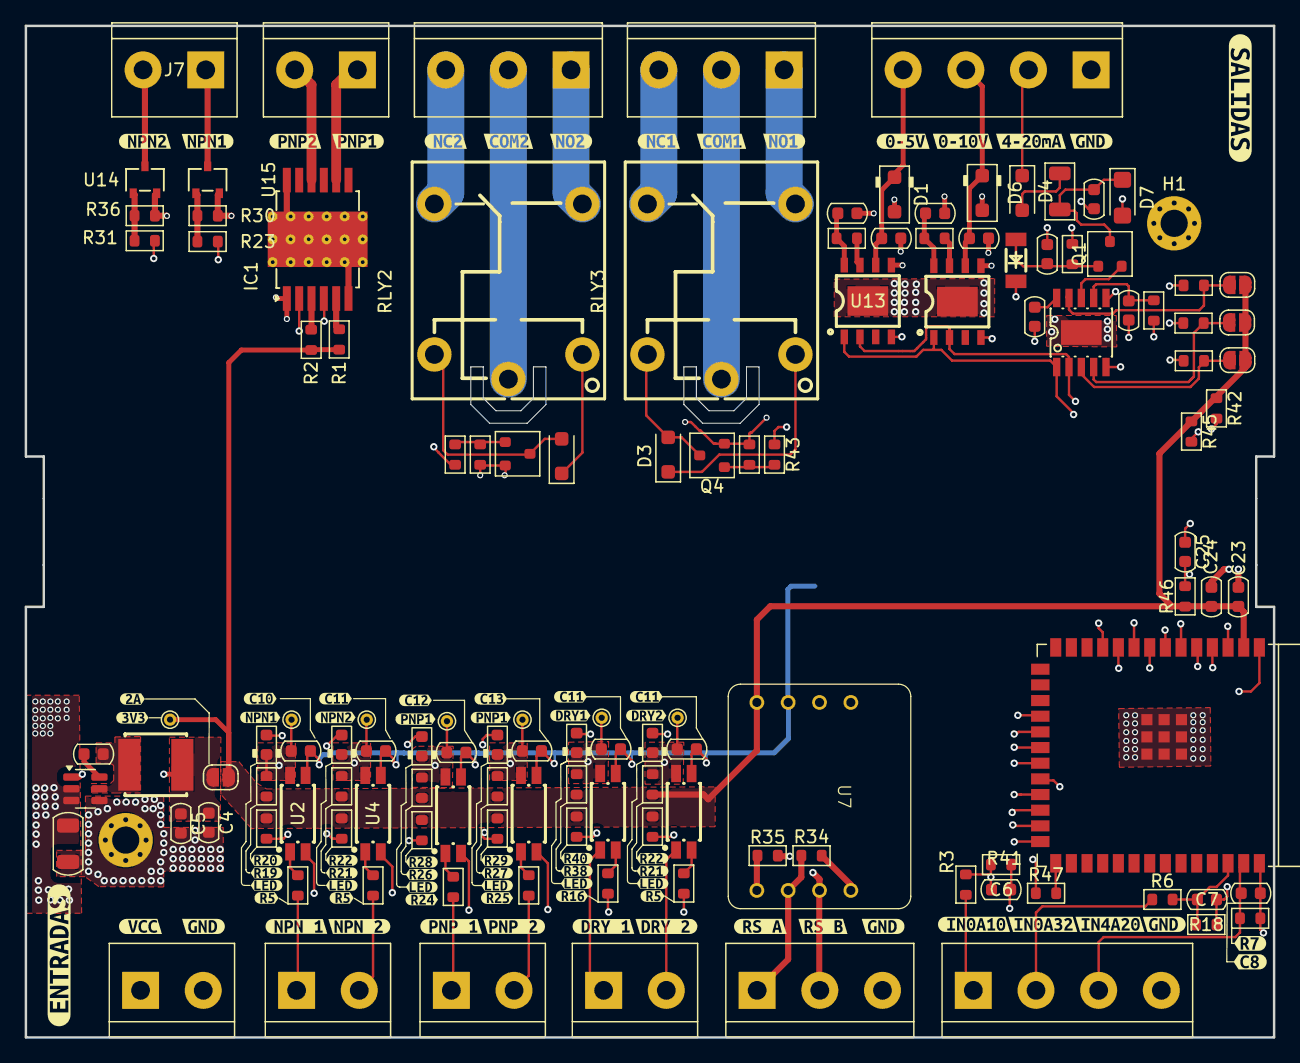
[picture p28: board NIVARA.kicad_pcb from above]

Board: 4 copper layers, 101.2 x 82.0 mm, 200 parts (0 on the bottom side), 85 nets.

Other parts of the board:
kibuzzard-68A4ACEC: G***; kibuzzard-68A4ACEC
kibuzzard-68A4AD1D: G***; kibuzzard-68A4AD1D
kibuzzard-68A4AD43: G***; kibuzzard-68A4AD43
kibuzzard-68A4AD55: G***; kibuzzard-68A4AD55
kibuzzard-68A4AE0E: G***; kibuzzard-68A4AE0E
kibuzzard-68A4AE1F: G***; kibuzzard-68A4AE1F
kibuzzard-68A4AE2A: G***; kibuzzard-68A4AE2A
kibuzzard-68A4AE4D: G***; kibuzzard-68A4AE4D
kibuzzard-68A4AE5E: G***; kibuzzard-68A4AE5E
kibuzzard-68A4AE56: G***; kibuzzard-68A4AE56
kibuzzard-68A4AF5B: G***; kibuzzard-68A4AF5B
kibuzzard-68A4AF27: G***; kibuzzard-68A4AF27
kibuzzard-68A4AF38: G***; kibuzzard-68A4AF38
kibuzzard-68A4AF50: G***; kibuzzard-68A4AF50
kibuzzard-68A4B67A: G***; kibuzzard-68A4B67A
kibuzzard-68A4B644: G***; kibuzzard-68A4B644
kibuzzard-68A851A1: G***; kibuzzard-68A851A1
kibuzzard-68A85187: G***; kibuzzard-68A85187
kibuzzard-68A85197: G***; kibuzzard-68A85197
kibuzzard-688D0FD4: G***; kibuzzard-688D0FD4
kibuzzard-688D4BEB: G***; kibuzzard-688D4BEB
kibuzzard-688D4BF9: G***; kibuzzard-688D4BF9
kibuzzard-688D4C3C: G***; kibuzzard-688D4C3C
kibuzzard-688D4C4D: G***; kibuzzard-688D4C4D
kibuzzard-688D4C16: G***; kibuzzard-688D4C16
kibuzzard-688D10E8: G***; kibuzzard-688D10E8
kibuzzard-688D10FC: G***; kibuzzard-688D10FC
kibuzzard-688D1008: G***; kibuzzard-688D1008
kibuzzard-6886A0F4: G***; kibuzzard-6886A0F4
kibuzzard-6886A071, kibuzzard-6886A071#2: G***; kibuzzard-6886A071
kibuzzard-6886A148, kibuzzard-6886A148#2, kibuzzard-6886A148#3: G***; kibuzzard-6886A148
kibuzzard-6886AD53: G***; kibuzzard-6886AD53
kibuzzard-6886AD61: G***; kibuzzard-6886AD61
kibuzzard-6886ADA1: G***; kibuzzard-6886ADA1
kibuzzard-6886ADC6: G***; kibuzzard-6886ADC6
kibuzzard-6886ADE0: G***; kibuzzard-6886ADE0
kibuzzard-6886ADF2: G***; kibuzzard-6886ADF2
kibuzzard-6886AE03: G***; kibuzzard-6886AE03
kibuzzard-6886AE16: G***; kibuzzard-6886AE16
kibuzzard-6886AE38: G***; kibuzzard-6886AE38
kibuzzard-6886AE62: G***; kibuzzard-6886AE62
kibuzzard-6886CB2B: G***; kibuzzard-6886CB2B
kibuzzard-6886CB54: G***; kibuzzard-6886CB54
kibuzzard-68857B38: G***; kibuzzard-68857B38
kibuzzard-68868B65: G***; kibuzzard-68868B65
kibuzzard-68868CAC: G***; kibuzzard-68868CAC
kibuzzard-68868CE5: G***; kibuzzard-68868CE5
kibuzzard-68868D86: G***; kibuzzard-68868D86
kibuzzard-68868DBB: G***; kibuzzard-68868DBB
kibuzzard-68868E7D: G***; kibuzzard-68868E7D
kibuzzard-68868E8A: G***; kibuzzard-68868E8A
kibuzzard-68868F64: G***; kibuzzard-68868F64
kibuzzard-68868F72: G***; kibuzzard-68868F72
kibuzzard-68869F01, kibuzzard-68869F01#2, kibuzzard-68869F01#3: G***; kibuzzard-68869F01
kibuzzard-688671E8: G***; kibuzzard-688671E8
kibuzzard-688672FE: G***; kibuzzard-688672FE
kibuzzard-688673E6, kibuzzard-688673E6#2: G***; kibuzzard-688673E6
kibuzzard-6886740D, kibuzzard-6886740D#2: G***; kibuzzard-6886740D
kibuzzard-68867375, kibuzzard-68867375#2, kibuzzard-68867375#3, kibuzzard-68867375#4, kibuzzard-68867375#5, kibuzzard-68867375#6: G***; kibuzzard-68867375
