JonatanMP/Jonatan_Matos_Electiva_2025_C2/(commit log)

2025-05-30 Se creo una carpeta para cada programa
    [Case PLC.FCStd]
2025-06-07 base del case del plc
    [Case PLC.FCStd]
2025-06-08 regitas de un lado
2025-06-11 Agrego DXF 2D, Termino 3D FrC, creacion Kicad
    Frc = freecad
    Se agrego el DXF tanto de la base como del case en freecad.
    Se termino el diseño 3D de Freecad, agregando pequeños detalles faltantes.
    Se empezo el proyecto de kicad, agregando las delimitaciones fisicas necesarias.
    [Case PLC.FCStd, NIVARA.kicad_pcb, NIVARA.kicad_sch, NIVARA_BOARD.kicad_sch, TOP_VIEW_Base.dxf, TOP_VIEW_Case.dxf]
2025-06-13 agregar cosas faltantes
    [Case PLC.FCStd, TOP_VIEW_Base.dxf, TOP_VIEW_Case.dxf]
2025-06-29 avance en diagramas
    [H_Briedge.kicad_sch, IN_NPN.kicad_sch, NIVARA_BOARD.kicad_sch, fuente_alimentacion.kicad_sch]
2025-07-09 AVANCES
    se realizaron avances con las entradas NPN, PNP. tambien se realizaron avances con las salidas de RELAYS
    [IN_NPN.kicad_sch, IN_PNP.kicad_sch, NIVARA.kicad_sch, NIVARA_BOARD.kicad_sch, RELAY.kicad_sch, fuente_alimentacion.kicad_sch]
2025-07-09 se agrego diodo de proteccion a los relays
    [RELAY.kicad_sch]
2025-07-09 se agregaron partnumbers
    [IN_NPN.kicad_sch, IN_PNP.kicad_sch, RELAY.kicad_sch, fuente_alimentacion.kicad_sch]
2025-07-09 RS_485 ADD MODULE
    [IN_NPN.kicad_sch, IN_PNP.kicad_sch, NIVARA_BOARD.kicad_sch, RELAY.kicad_sch, RS_485.kicad_sch, fuente_alimentacion.kicad_sch]
2025-07-14 se agrego hirarchical de esp32 s3
    [ESP32_S3.kicad_sch, INA0-05V.kicad_sch, INA0-10V.kicad_sch, INA0-32V.kicad_sch, INA4-20mA.kicad_sch, IN_A_0-10V.kicad_sch, NIVARA_BOARD.kicad_sch, OUTA0-05V.kicad_sch]
2025-07-17 SALIDAS DE VOLTAJE Y CORRIENTE
    [ESP32_S3.kicad_sch, IN_D.kicad_sch, IN_NPN.kicad_sch, IN_PNP.kicad_sch, NIVARA_BOARD.kicad_sch, OUTA0-05V.kicad_sch, OUTA0-10V.kicad_sch, OUTA4-20mA.kicad_sch]
2025-07-28 Se organizaron componentes en el area de PCB
    [ESP32_S3.kicad_sch, INA0-10V.kicad_sch, INA0-32V.kicad_sch, INA4-20mA.kicad_sch, IN_D.kicad_sch, IN_DRY.kicad_sch, IN_DRY_Opto.kicad_sch, IN_NPN.kicad_sch]
2025-08-01 organizando componentes en la pcb
    [INA0-32V.kicad_sch, IN_DRY_Opto.kicad_sch, NIVARA.kicad_pcb, NIVARA.kicad_sch]
2025-08-08 ACTUALIZACION DE SALIDAS NPN Y PNP
    [ESP32_S3.kicad_sch, INA0-32V.kicad_sch, INA4-20mA.kicad_sch, NIVARA.kicad_pcb, OUTA0-10V.kicad_sch, OUTA4-20mA.kicad_sch, OUT_NPN.kicad_sch, OUT_PNP.kicad_sch]
2025-08-19 arreglo del desastre que tenia con las salidas PNP
    [ESP32_S3.kicad_sch, IN_DRY_Opto.kicad_sch, IN_NPN_ISOLATE.kicad_sch, IN_PNP_ISOLATE.kicad_sch, NIVARA.kicad_pcb, NIVARA.kicad_sch, NIVARA_BOARD.kicad_sch, OUTA0-05V.kicad_sch]
2025-08-22 se extendio GND
    [NIVARA.kicad_pcb]
2025-08-22 ruteo de salidas
    [ESP32_S3.kicad_sch]
2025-08-22 RUTEO ENTRADAS
    [NIVARA.kicad_pcb]
